james-techne/filter_actuator_rev1/filter_actuator_rev1.1.step

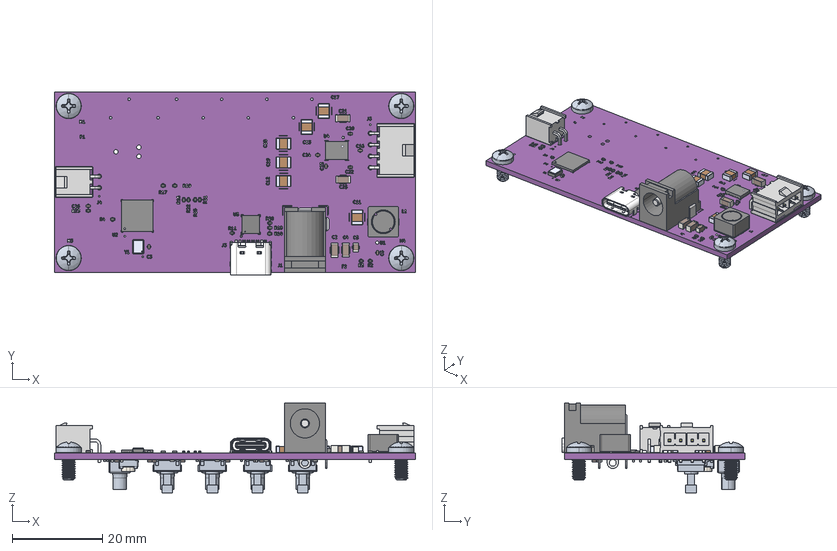
[picture p1: CAD file, 2026-09-14]
filter_actuator_rev1.1.step
80.0 x 40.6 x 19.9 mm
R_0402_1005Metric x 24
C_0402_1005Metric x 19
IPL1-104-01-S-RA-K_HDR
T-1S64-01-04-F-S-RA
T-1S64-01-04-F-S-RA2
Same_Sky_UJ20-C-H-G-SMT-2A-P16-TR
1210CA102JAT1A-COL x 6
C_1206_3216Metric x 4
ECS-2333-018-BN-TR
C_0805_2012Metric
94879A116_Off-White Nylon Phillips Rounded Head Screws x 4
IPL1-102-01-S-RA-K_HDR
T-1S64-01-02-F-S-RA
T-1S64-01-02-F-S-RA2
MP6602GV
STM32U585CIU6Q
SRR6038-6R2Y
CUI_DEVICES_PJ-002AH
B3FS_105[] x 4
51513140250DF_SW0001 x 5
LTST-C190KGKT x 5
PTS815SJM250SMTRLFS_PART1
PTS815SJM250SMTRLFS_PART2
PTS815SJM250SMTRLFS_PART3_2
PTS815SJM250SMTRLFS_PART3
PTS815SJM250SMTRLFS_PART3_1
PTS815SJM250SMTRLFS_PART3_4
PTS815SJM250SMTRLFS_PART3_3
filter_actuator_rev1_silkscreen x 2
filter_actuator_rev1_PCB
