james-techne/filter_actuator_rev1/filter_actuator_rev1.step

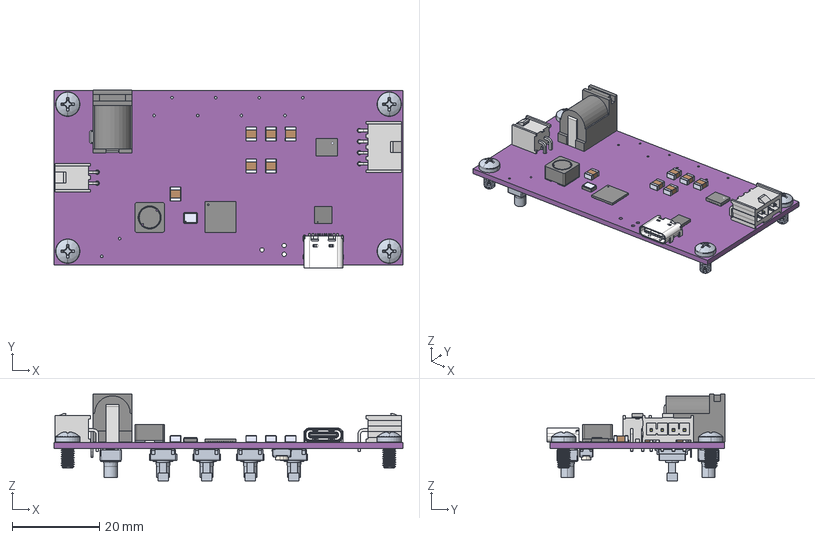
[picture p2: CAD file, 2026-09-08, an earlier design]
filter_actuator_rev1.step
80.0 x 40.7 x 19.9 mm
IPL1-104-01-S-RA-K_HDR
T-1S64-01-04-F-S-RA
T-1S64-01-04-F-S-RA2
Same_Sky_UJ20-C-H-G-SMT-2A-P16-TR
1210CA102JAT1A-COL x 6
ECS-2333-018-BN-TR
94879A116_Off-White Nylon Phillips Rounded Head Screws x 4
IPL1-102-01-S-RA-K_HDR
T-1S64-01-02-F-S-RA
T-1S64-01-02-F-S-RA2
MP6602GV
STM32U585CIU6Q
SRR6038-6R2Y
CUI_DEVICES_PJ-002AH
B3FS_105[] x 4
51513140250DF_SW0001 x 5
LTST-C190KGKT x 5
PTS815SJM250SMTRLFS_PART1
PTS815SJM250SMTRLFS_PART2
PTS815SJM250SMTRLFS_PART3_2
PTS815SJM250SMTRLFS_PART3
PTS815SJM250SMTRLFS_PART3_1
PTS815SJM250SMTRLFS_PART3_4
PTS815SJM250SMTRLFS_PART3_3
filter_actuator_rev1_PCB
