james-techne/filter_actuator_rev1/filter_actuator_rev1.kicad_pcb

## KiCad design filter_actuator_rev1.kicad_pcb (2026-09-20)

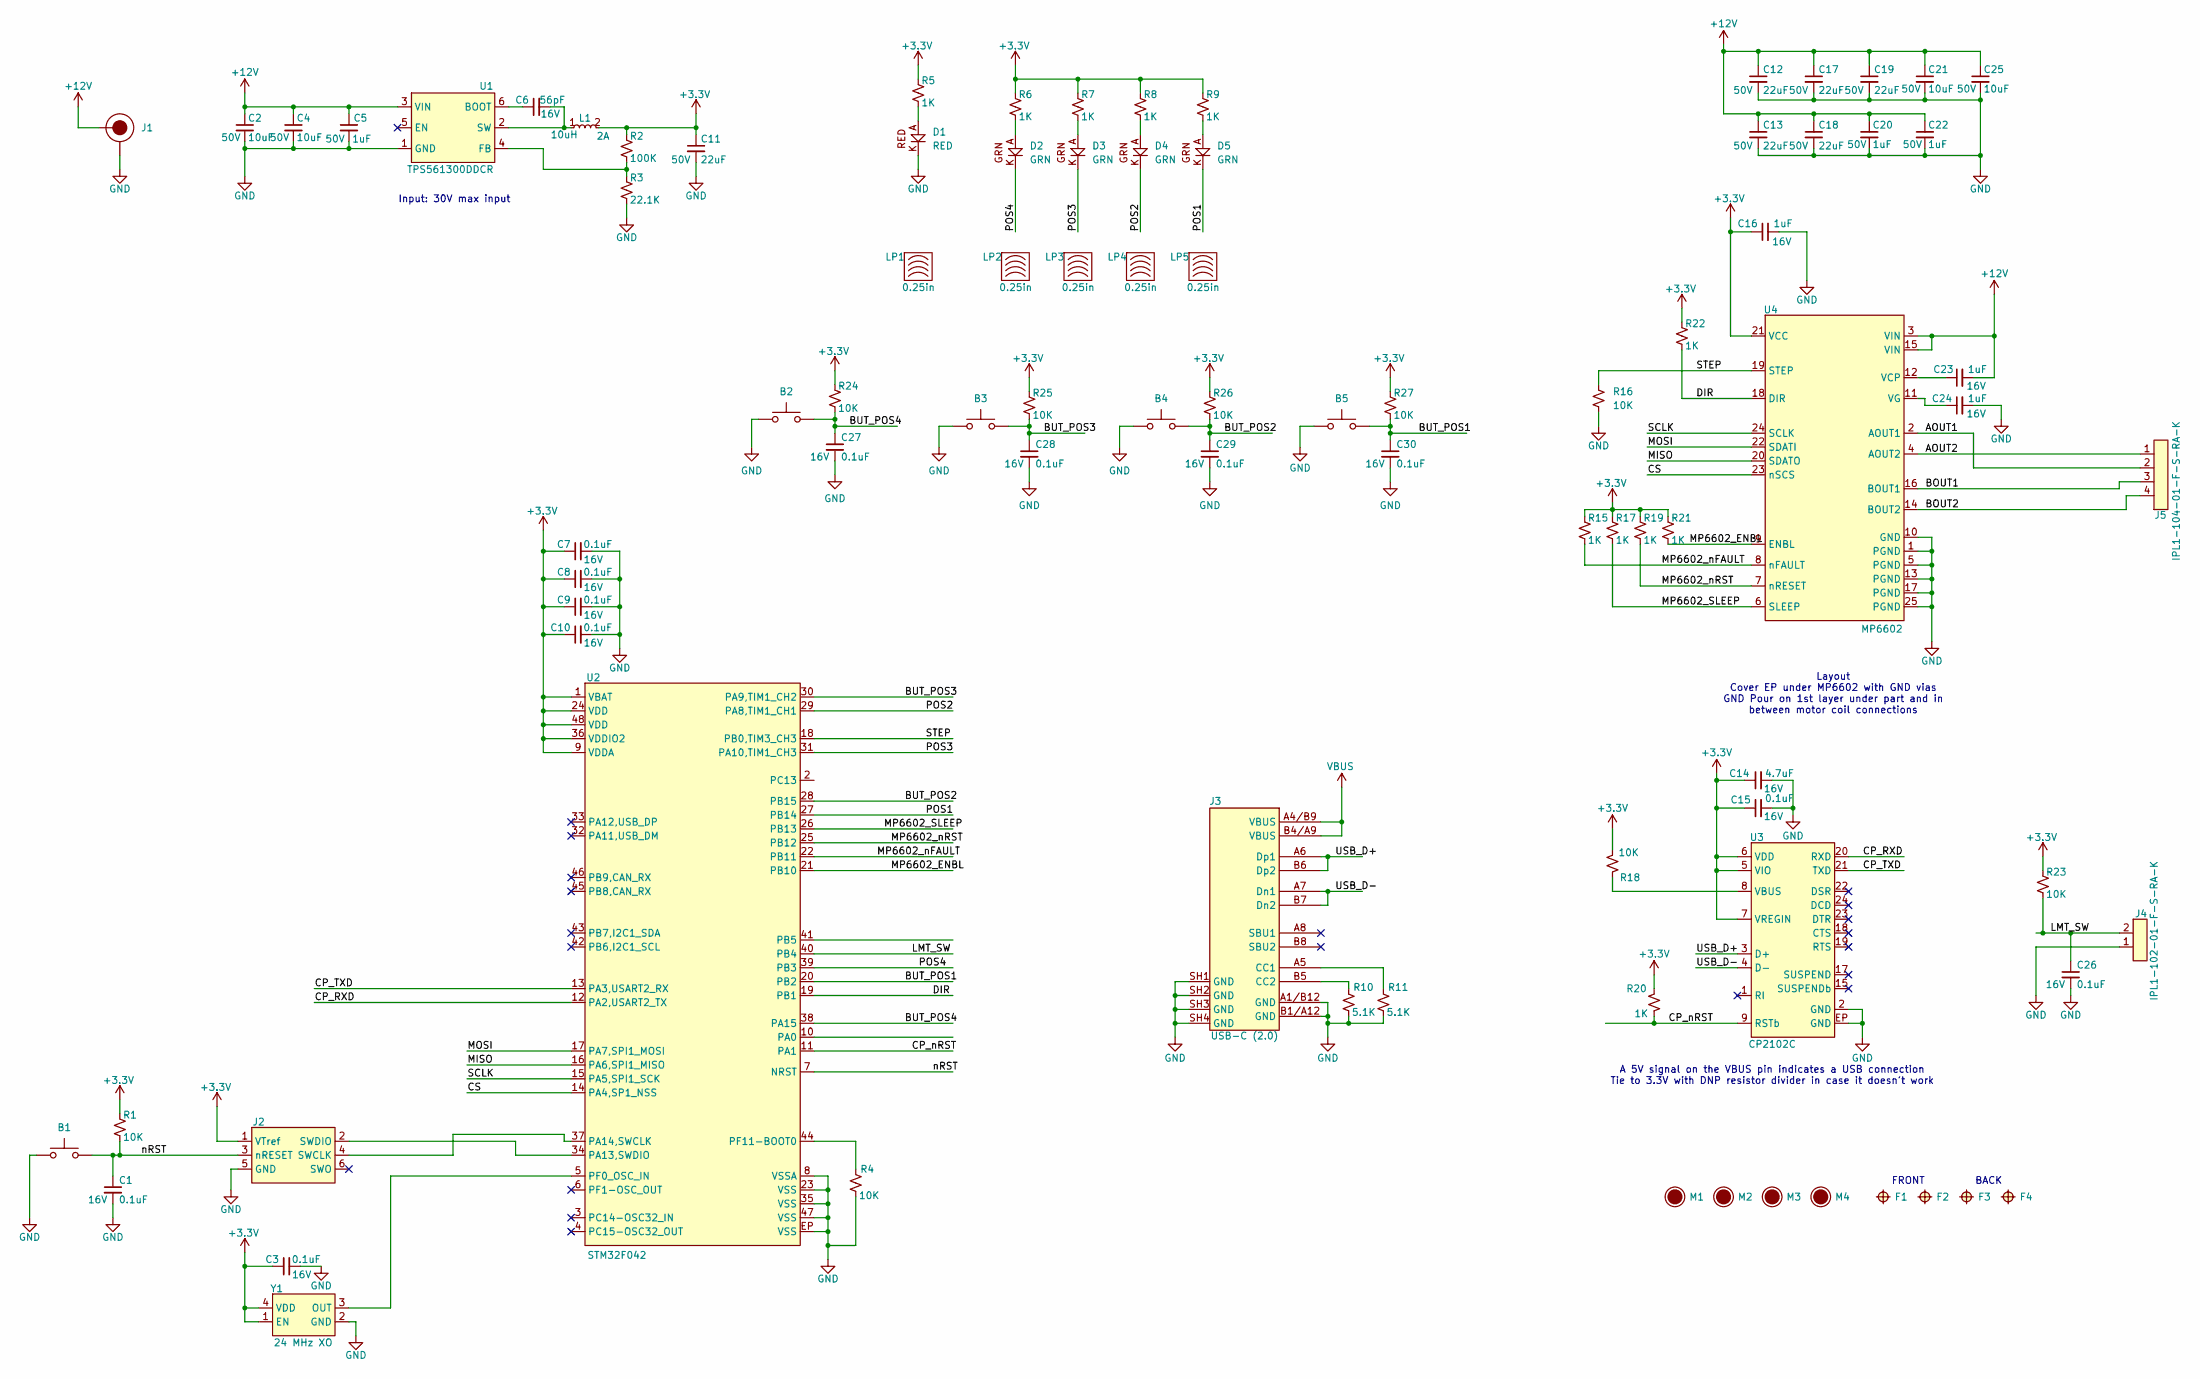
[picture p3: schematic filter_actuator_rev1.kicad_sch, Luxel Filter Actuator Motor Drive Board]

Parts:
B1: C&K_pushbutton; MPN PTS815SJM250SMTRLFS
B2, B3, B4, B5: B3FS-1032; MPN B3FS-1052
C1, C3, C7, C8, C9, C10, C15, C26, C27, C28, C29, C30: 0.1uF; C_0402_1005Metric; Voltage Rating 16V; MPN GRM155R61C104KA88D
C2, C4, C21, C25: 10uF; C_1206_3216Metric; Voltage Rating 50V; MPN GRT31CR61H106KE01K
C5: 1uF; C_0805_2012Metric; Voltage Rating 50V; MPN GCM21BR71H105KA03L
C6: 56pF; C_0402_1005Metric; Voltage Rating 16V; MPN KGM05ACG1C560KH
C11, C12, C13, C17, C18, C19: 22uF; C_1812_4532Metric; Voltage Rating 50V; MPN GMC43X7R226K50NT
C14: 4.7uF; C_0402_1005Metric; Voltage Rating 16V; MPN KGM05CR51C475MH
C16, C23, C24: 1uF; C_0402_1005Metric; Voltage Rating 16V; MPN CL05A105KO5NNNC
C20, C22: 1uF; C_0402_1005Metric; Voltage Rating 50V; MPN UMK105CBJ105MV-F
D1: RED; LIteOn_0603; MPN LTST-C191KRKT
D2, D3, D4, D5: GRN; LIteOn_0603; MPN LTST-C190KGKT
F1, F2, F3, F4: fiducial_1mm_2mm
J1: PJ-002AH_Power Barrel; MPN PJ-002AH
J2: JLink_needle_6pin; MPN N/A
J3: USB-C (2.0); SAMESKY_UJ20-C-H-G-SMT-2A-P16-TR; MPN UJ20-C-H-G-SMT-2A-P16-TR
J4: IPL1-102-01-F-S-RA-K; SAMTEC_IPL1-102-01-X-S-RA-K; MPN IPL1-106-01-F-S-RA-K
J5: IPL1-104-01-F-S-RA-K; SAMTEC_IPL1-104-01-X-S-RA-K; MPN IPL1-106-01-F-S-RA-K
L1: 10uH; IND_SRR6038-100Y; Rating 2A; MPN SRR6038-100Y
LP1, LP2, LP3, LP4, LP5: 0.25in; Dialight_515-1314-xxxx; MPN 515-1314-0250PF
M1, M2, M3, M4: M3_NPLATED_TH; MPN N/A
R1, R4, R16, R18, R23, R24, R25, R26, R27: 10K; R_0402_1005Metric; MPN RC0402FR-0710KP
R2: 100K; R_0402_1005Metric; MPN RC0402FR-07100KL
R3: 22.1K; R_0402_1005Metric; MPN RC0402FR-1322K1L
R5, R6, R7, R8, R9, R15, R17, R19, R20, R21, R22: 1K; R_0402_1005Metric; MPN RC0402FR-071KL
R10, R11: 5.1K; R_0402_1005Metric; MPN RC0402FR-075K1L
U1: TPS561300DDCR; ti_DDC0006A_SOT23; MPN TPS561300DDCR
U2: STM32F042; QFN50P700X700X60-49N; MPN STM32F042C6U6
U3: CP2102C; IC_QFN24_SIL; MPN CP2102C-A01-GQFN24R
U4: MP6602; QFN-25_MP6602_MNP; MPN MP6602GV-Z
Y1: 24 MHz XO; OSC_ECS-2333-480-BN-TR; MPN ECS-2333-240-BN-TR

Connections:
+3.3V: C3.1, C7.1, C8.1, C9.1, C10.1, C11.1, C14.1, C15.1, C16.1, J2.1 (VTref), L1.2, R1.1, R2.1, R5.1, R6.1, R7.1, R8.1, R9.1, R15.1, R17.1, R18.2, R19.1, R20.1, R21.1, R22.1, R23.1, R24.1, R25.1, R26.1, R27.1, U2.1 (VBAT), U2.9 (VDDA), U2.24 (VDD), U2.36 (VDDIO2), U2.48 (VDD), U3.5 (VIO), U3.6 (VDD), U3.7 (VREGIN), U4.21 (VCC), Y1.1 (EN), Y1.4 (VDD)
+12V: C2.1, C4.1, C5.1, C12.1, C13.1, C17.1, C18.1, C19.1, C20.1, C21.1, C22.1, C23.2, C25.1, J1.1 (V+), U1.3 (VIN), U4.3 (VIN), U4.15 (VIN)
/AOUT1: J5.2, U4.2 (AOUT1)
/AOUT2: J5.1, U4.4 (AOUT2)
/BOUT1: J5.3, U4.16 (BOUT1)
/BOUT2: J5.4, U4.14 (BOUT2)
/BUT_POS1: B5.4, C30.1, R27.2, U2.20 (PB2)
/BUT_POS2: B4.4, C29.1, R26.2, U2.28 (PB15)
/BUT_POS3: B3.4, C28.1, R25.2, U2.30 (PA9,TIM1_CH2)
/BUT_POS4: B2.4, C27.1, R24.2, U2.38 (PA15)
/CP_RXD: U2.12 (PA2,USART2_TX), U3.20 (RXD)
/CP_TXD: U2.13 (PA3,USART2_RX), U3.21 (TXD)
/CP_nRST: R20.2, U2.11 (PA1), U3.9 (RSTb)
/CS: U2.14 (PA4,SP1_NSS), U4.23 (nSCS)
/DIR: R22.2, U2.19 (PB1), U4.18 (DIR)
/LMT_SW: C26.1, J4.2, R23.2, U2.40 (PB4)
/MISO: U2.16 (PA6,SPI1_MISO), U4.20 (SDATO)
/MOSI: U2.17 (PA7,SPI1_MOSI), U4.22 (SDATI)
/MP6602_ENBL: R21.2, U2.21 (PB10), U4.9 (ENBL)
/MP6602_SLEEP: R17.2, U2.26 (PB13), U4.6 (SLEEP)
/MP6602_nFAULT: R15.2, U2.22 (PB11), U4.8 (nFAULT)
/MP6602_nRST: R19.2, U2.25 (PB12), U4.7 (nRESET)
/POS1: D5.K, U2.27 (PB14)
/POS2: D4.K, U2.29 (PA8,TIM1_CH1)
/POS3: D3.K, U2.31 (PA10,TIM1_CH3)
/POS4: D2.K, U2.39 (PB3)
/SCLK: U2.15 (PA5,SPI1_SCK), U4.24 (SCLK)
/STEP: R16.1, U2.18 (PB0,TIM3_CH3), U4.19 (STEP)
/USB_D+: J3.A6 (Dp1), J3.B6 (Dp2), U3.3 (D+)
/USB_D-: J3.A7 (Dn1), J3.B7 (Dn2), U3.4 (D-)
/nRST: B1.4, C1.1, J2.3 (nRESET), R1.2, U2.7 (NRST)
GND: B1.1, B1.2, B2.1, B2.2, B3.1, B3.2, B4.1, B4.2, B5.1, B5.2, C1.2, C2.2, C3.2, C4.2, C5.2, C7.2, C8.2, C9.2, C10.2, C11.2, C12.2, C13.2, C14.2, C15.2, C16.2, C17.2, C18.2, C19.2, C20.2, C21.2, C22.2, C24.2, C25.2, C26.2, C27.2, C28.2, C29.2, C30.2, D1.K, J1.2 (GND), J1.3 (GND), J2.5 (GND), J3.A1/B12 (GND), J3.B1/A12 (GND), J3.SH1 (GND), J3.SH2 (GND), J3.SH3 (GND), J3.SH4 (GND), J4.1, R3.2, R4.2, R10.2, R11.2, R16.2, U1.1 (GND), U2.8 (VSSA), U2.23 (VSS), U2.35 (VSS), U2.47 (VSS), U2.EP (VSS), U3.2 (GND), U3.EP (GND), U4.1 (PGND), U4.5 (PGND), U4.10 (GND), U4.13 (PGND), U4.17 (PGND), U4.25 (PGND), Y1.2 (GND)
unnamed: D1.A, R5.2
unnamed: D2.A, R6.2
unnamed: D3.A, R7.2
unnamed: D4.A, R8.2
unnamed: D5.A, R9.2
unnamed: J2.4 (SWCLK), U2.37 (PA14,SWCLK)
unnamed: J2.2 (SWDIO), U2.34 (PA13,SWDIO)
unnamed: J3.A5 (CC1), R11.1
unnamed: J3.B5 (CC2), R10.1
unnamed: C6.1, U1.6 (BOOT)
unnamed: R2.2, R3.1, U1.4 (FB)
unnamed: C6.2, L1.1, U1.2 (SW)
unnamed: U2.5 (PF0_OSC_IN), Y1.3 (OUT)
unnamed: R4.1, U2.44 (PF11-BOOT0)
unnamed: R18.1, U3.8 (VBUS)
unnamed: C23.1, U4.12 (VCP)
unnamed: C24.1, U4.11 (VG)
VBUS: J3.A4/B9 (VBUS), J3.B4/A9 (VBUS)

Notes on the sheet:
A 5V signal on the VBUS pin indicates a USB connection Tie to 3.3V with DNP resistor divider in case it doesn't work
Layout Cover EP under MP6602 with GND vias GND Pour on 1st layer under part and in between motor coil connections
Input: 30V max input
BACK
FRONT

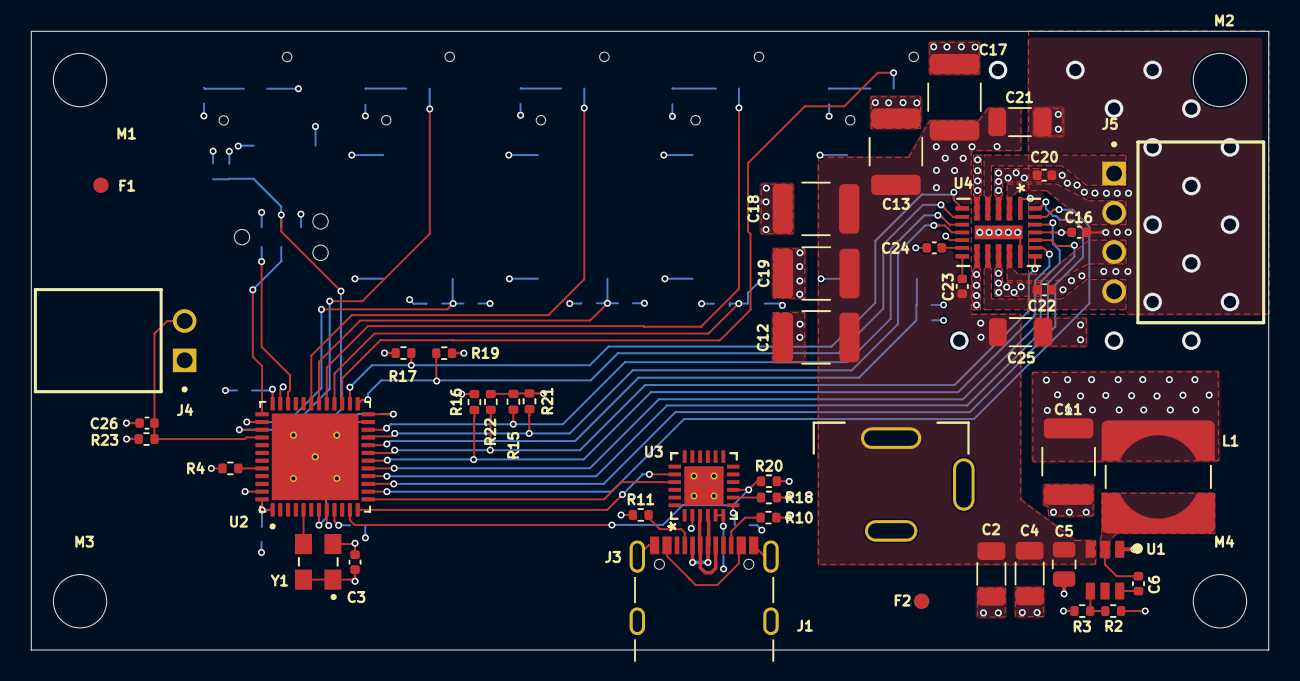
[picture p4: board filter_actuator_rev1.kicad_pcb from above]

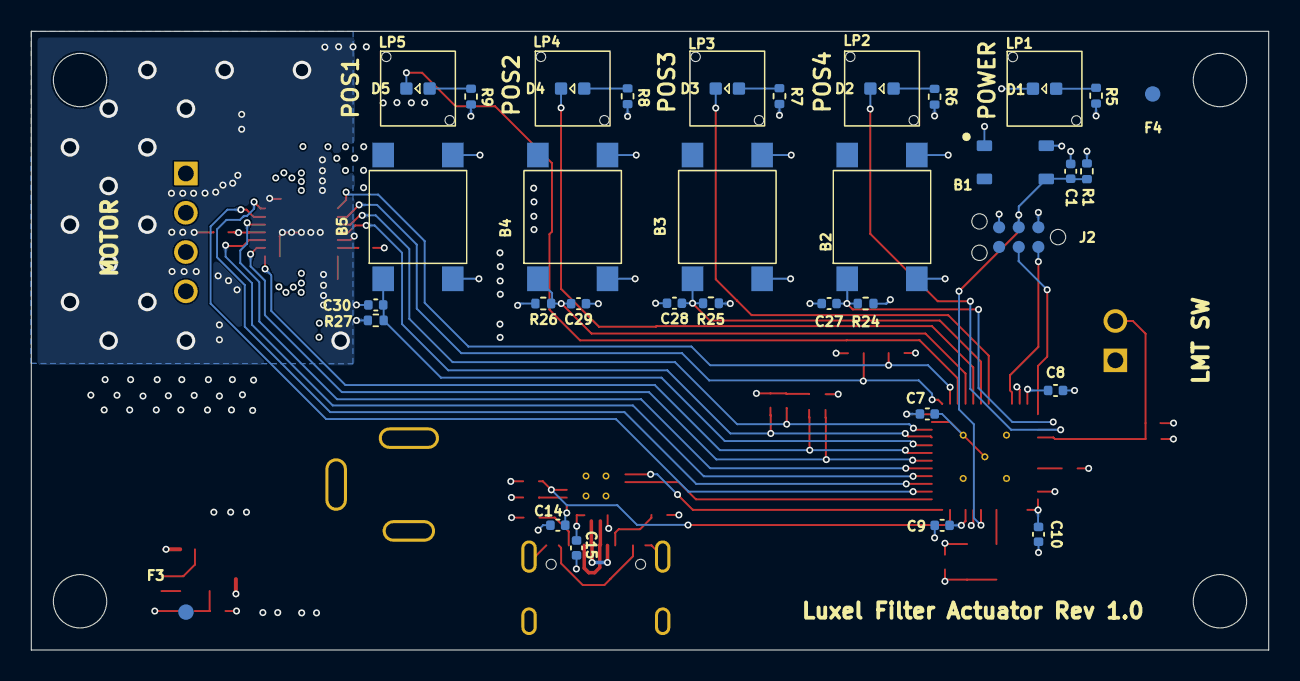
[picture p5: board filter_actuator_rev1.kicad_pcb from below]

Board: 4 copper layers, 80.0 x 40.0 mm, 88 parts (39 on the bottom side), 50 nets.
