james-techne/filter_actuator_rev1/(commit log)

2026-09-02 First push to get schematic ready
    [filter_actuator_rev1.kicad_sch]
2026-09-08 Finished part placement. Waiting on some feedback from Patrick on connector and interface placement.
    [filter_actuator_rev1.kicad_pcb, filter_actuator_rev1.kicad_sch, filter_actuator_rev1.step]
2026-09-11 Doing a commit because laptop is about to crash
    [filter_actuator_rev1.kicad_pcb, filter_actuator_rev1.kicad_sch]
2026-09-14 Initial layout complete. Need to review before ordering.
    [filter_actuator_rev1.1.step, filter_actuator_rev1.kicad_pcb, filter_actuator_rev1.kicad_sch]
2026-09-20 Tag as ordered for fab from JLC. Official Rev1
    [filter_actuator_rev1-B_Cu.gbr, filter_actuator_rev1-B_Mask.gbr, filter_actuator_rev1-B_Paste.gbr, filter_actuator_rev1-B_Silkscreen.gbr, filter_actuator_rev1-Edge_Cuts.gbr, filter_actuator_rev1-F_Cu.gbr, filter_actuator_rev1-F_Mask.gbr, filter_actuator_rev1-F_Paste.gbr]
